HolographicX/fracley/BOM.csv

name | quantity | price (US$) | total (US$) | notes | link
80/600mm Doublet Lens | 1 | 64.42 | 64.42 | D80F600G (Green Film). Disclaimer: I actually haven't tested this particular linked item. They should all be the same, but I'd love to test them out and see if one seller is better! | https://www.aliexpress.us/item/3256807550516817.html?pdp_ext_f=%7B%22order%22%3A%221%22%7D
12x10x500mm Carbon Fiber Rods | 3 | 3.25 | 9.75 | Steel rods also work | https://www.aliexpress.us/item/3256802077714293.html
M3x 4.5 Threaded Inserts | 18 | 2.19 | 2.19 | 50 pcs | https://www.aliexpress.us/item/3256803396040989.html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
M3 x 6mm Screws Socket Head | 18 | 3.5 | 3.5 | 100 pcs | https://www.aliexpress.us/item/2251832608527529.html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
M5 x 5mm threaded Inserts | 3 | 2.66 | 2.66 | 50 pcs | https://www.aliexpress.us/item/3256803396040989.html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
M5 x 6mm Screws Socket Head | 3 | 1.78 | 1.78 | 10 pcs | https://www.aliexpress.us/item/3256807882500328.html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
4mm bearing balls | 6 | 2.52 | 2.52 | 4mm 100 pcs | https://www.aliexpress.us/item/3256808582039444.html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
PTFE Tubing | 1 | 1.52 | 1.52 | 1 meter | https://www.aliexpress.us/item/3256809408451561.html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
TOTAL |  |  | 88.34
