HolographicX/fracley/CAD/STL/Fracley - Lens Cell Inner.stl

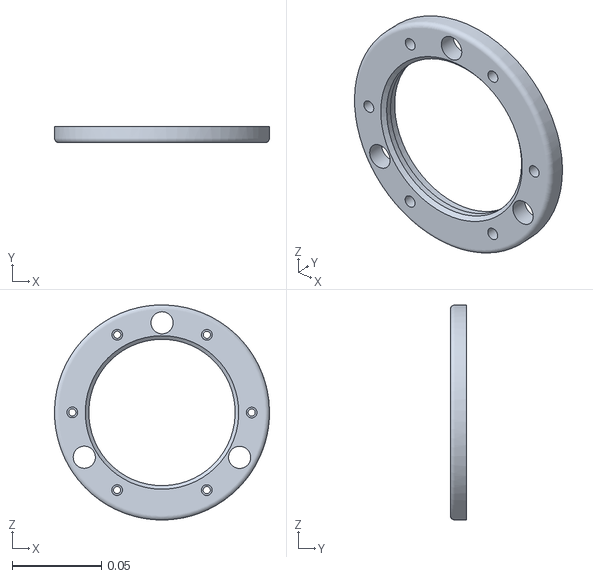
[picture p1: CAD file, 2025-08-02]
CAD/STL/Fracley - Lens Cell Inner.stl
0.12 x 0.00923 x 0.12
