HolographicX/fracley/CAD/STL/Fracley parts - Back Cover.stl

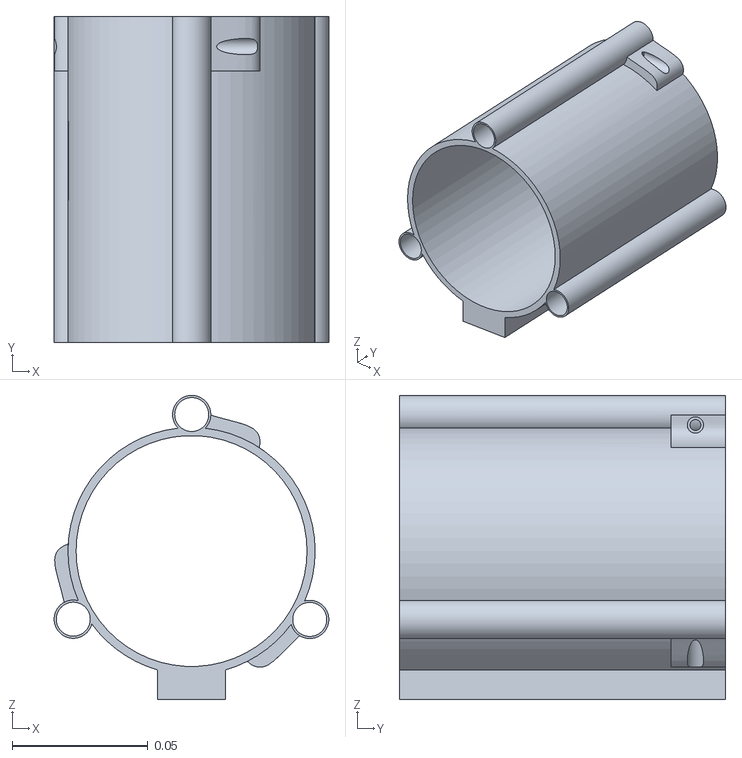
[picture p2: CAD file, 2025-08-02]
CAD/STL/Fracley parts - Back Cover.stl
0.101 x 0.12 x 0.112
