HolographicX/fracley/CAD/STL/Fracley - Drawtube Attachment.stl

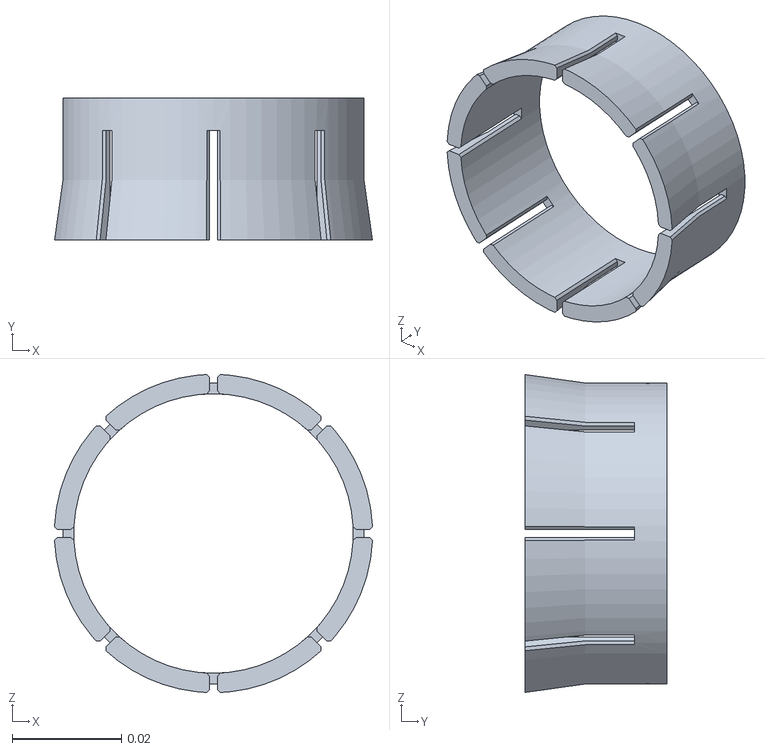
[picture p3: CAD file, 2025-08-02]
CAD/STL/Fracley - Drawtube Attachment.stl
0.0582 x 0.026 x 0.0582
