HolographicX/fracley/CAD/STL/Fracley - Focuser Joint.stl

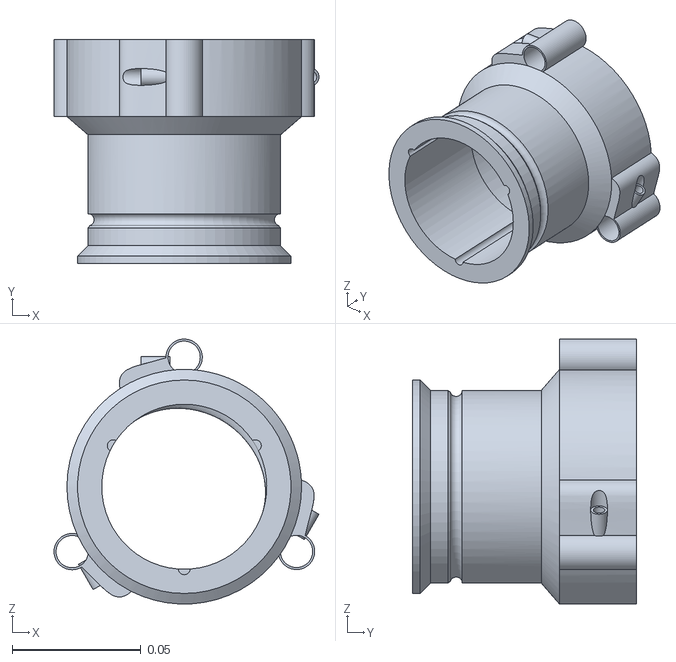
[picture p4: CAD file, 2025-08-02]
CAD/STL/Fracley - Focuser Joint.stl
0.103 x 0.087 x 0.103
