HolographicX/fracley/CAD/STL/Fracley - Lens Cell Outer.stl

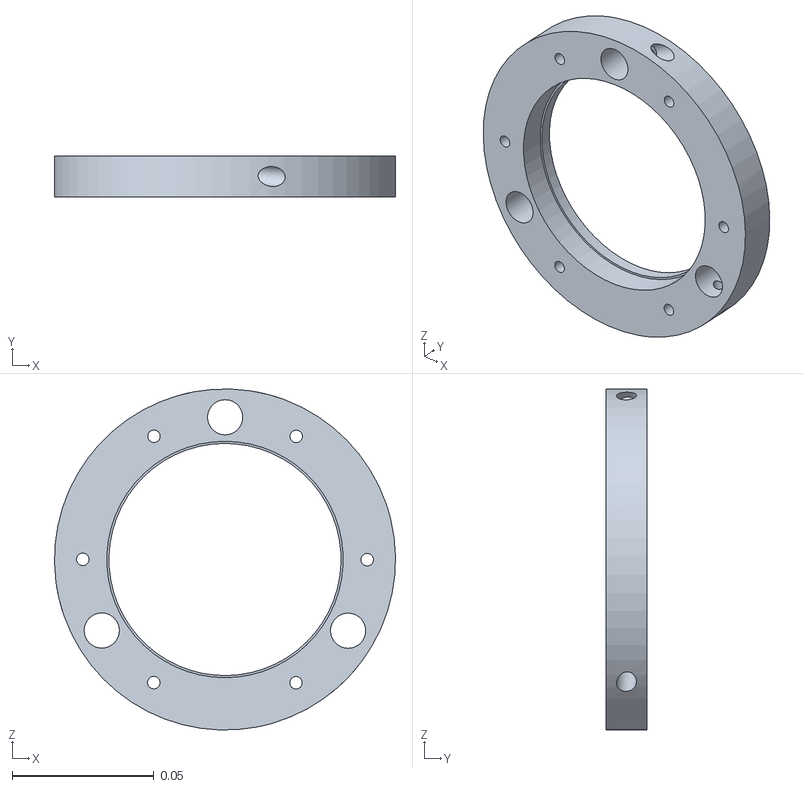
[picture p5: CAD file, 2025-08-02]
CAD/STL/Fracley - Lens Cell Outer.stl
0.12 x 0.0143 x 0.12
