HolographicX/fracley/CAD/STL/Fracley - Front Cover.stl

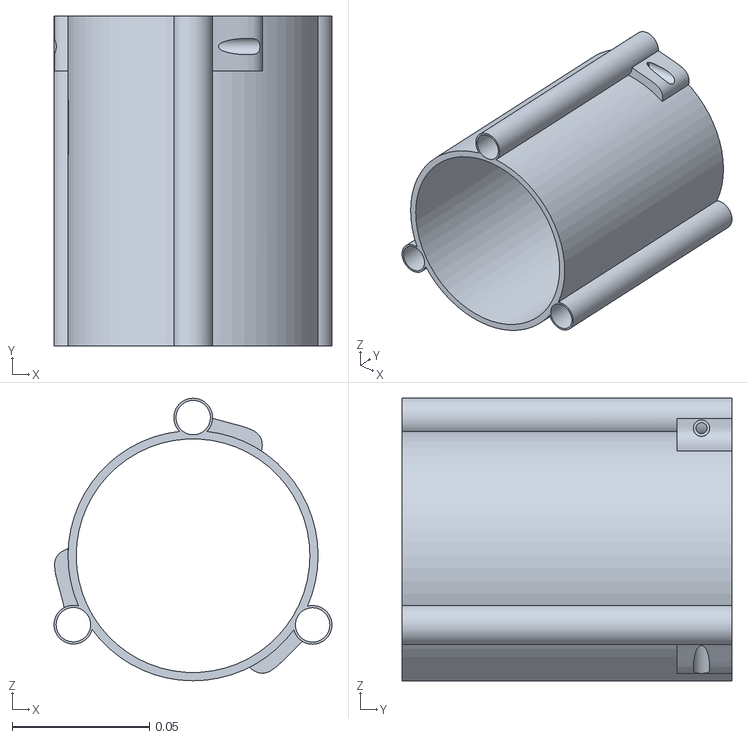
[picture p6: CAD file, 2025-08-02]
CAD/STL/Fracley - Front Cover.stl
0.101 x 0.12 x 0.103
