HolographicX/fracley/CAD/STL/Fracley - Focuser Locking Ring.stl

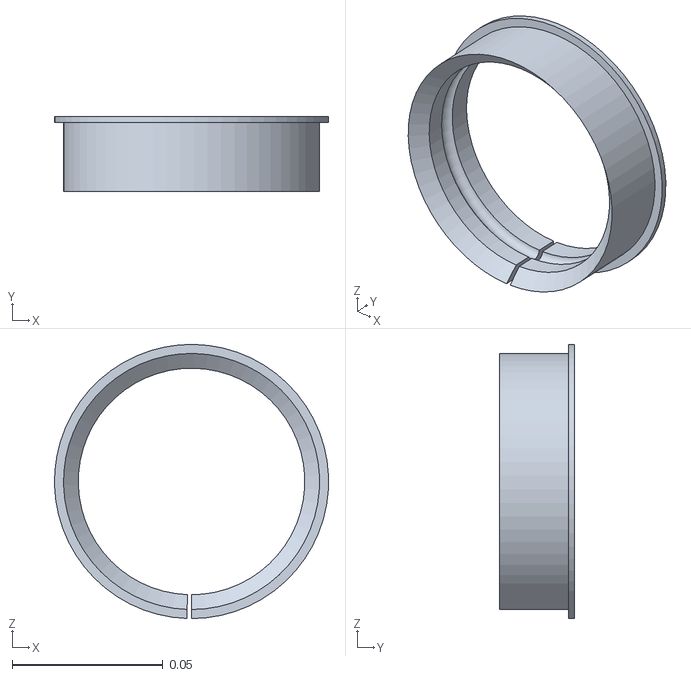
[picture p7: CAD file, 2025-08-02]
CAD/STL/Fracley - Focuser Locking Ring.stl
0.0907 x 0.0248 x 0.0908
