HolographicX/fracley/CAD/STL/Fracley - Focus Nut.stl

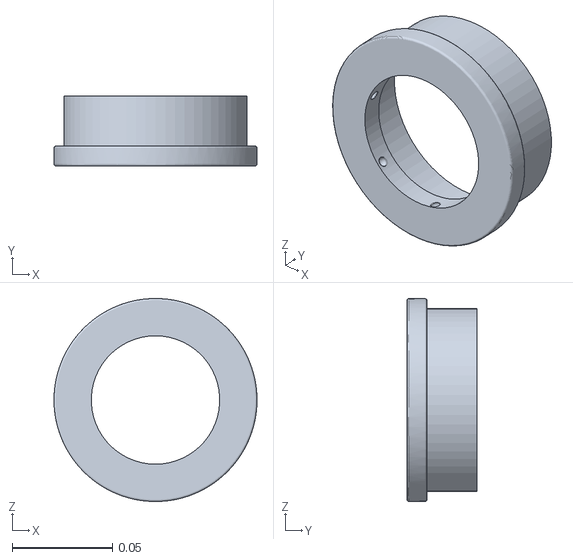
[picture p8: CAD file, 2025-08-02]
CAD/STL/Fracley - Focus Nut.stl
0.101 x 0.035 x 0.101
