HolographicX/fracley/(commit log)

2025-08-02 Add BOM.csv
    [BOM.csv]
2025-08-02 Add Printed Parts List
    [Printed Parts.csv]
2025-08-02 Add CAD
    [Fracley - Drawtube Attachment.stl, Fracley - Focus Nut.stl, Fracley - Focuser Joint.stl, Fracley - Focuser Locking Ring.stl, Fracley - Front Cover.stl, Fracley - Lens Cell Inner.stl, Fracley - Lens Cell Outer.stl, Fracley parts - Back Cover.stl]
2025-08-02 Update BOM
    [BOM.csv]
